kuboki-takeshi/opamp_ishikai_2026-05-06/readme.md

# ISHI会 OPAMP製造記録

## 概要

私、Shuntaro OHNOがISHI会の「[2025年09月イベント：二日でOPAMP回路ハンズオン](https://ishikai.connpass.com/event/363412/)」で作成したオペアンプ（OPAMP）の製造記録です。

設計の目標、設計の流れ・考えていたこと、製造されたOPAMPの計測結果をまとめました。

## 目標

- 初めての半導体製造なので、なんとか動くオペアンプを作りたい
- 指定された面積（600um × 200um）にレイアウトを押し込みたい

## 【2026/05/06】「愛の説教部屋」でご指導いただきたいこと

[2026年5月イベント「ISHI会三周年記念イベント～学生＆新人、半導体初心者に贈る！～」東京会場](https://ishikai.connpass.com/event/381973/)の「愛の説教部屋」にて、広島大学の久保木先生にお伺いしたいことをまとめました。

設計時に私が考えていたことや、製造されたOPAMPの計測記録はこの後にまとめています。
素人が付け焼刃で作った記録をご覧に入れるのは大変心苦しいのですが、どうぞ厳しいコメントをいただけますと幸いです。

- 「設計の流れ・考えていたこと」で、根本的に誤解していることや、もっと時間をかけて検証すべきだったことはありますか？とくに、以下の点が気になっています。
    - バイアス電流・バイアス電位の正しい決め方が知りたいです。設計時はその重要性を軽視していて、適当に決めたり、シミュレーションサンプルのデフォルト値をとりあえず使ったりしてしまいました。また、製造されたOPAMPの計測結果からは、バイアス電流が不足していたのではないかと疑っています。
    - 各MOSのオーバードライブ電圧は、明確に決めておいた方が良いのでしょうか？もしかして、オーバードライブ電圧を全MOSで統一しておいた方が良い、ということもあるのでしょうか？その場合、Vgsは低消費電力を狙ってVth+0.1V=0.9V程度にするのが良いのか、差動増幅段の出力である1.5V程度に余裕を持たせる方が良いのか、知りたいです。

> - 大きな誤解はなさそうですが、個々の要素回路とそれらを組み合わせた際の整合がやや取れていないように見えました。一方、時間をかけて検証するべき点としては、回路の定数決定の際に1回だけではなく何度かループさせて検証することをおすすめしたいと思います。今回と採用した設計手法はすべてのトランジスタが想定した動作店で動作する際にシステマティックに定数が決まるというものですが、実際にはDC, AC, TRANのシミュレーション結果を見て、いったん決めた定数を微調整する必要があります。回路設計の際の仕様（とりあえず動くものとはいえ利得や帯域などの目標値）や設計回路をシミュレーション(または実測も）で評価するテストベンチが定まっていると、電気特性の不審な点に気づくこともあります。
>
>     - 現在の設定ではカレントミラーのMOSは線形領域で動作している可能性があります。重要なのは各段に必要な電流をどのように見積もるのかであり、その電流を分配するのがこのバイアス電流とカレントミラーです。この時に必要な電流は、設計するオペアンプで想定するSRと負荷容量（＋できれば仮置きした位相補償容量）の積で求まる電流が2段目の最低限必要な電流となります。同様に差動増幅段についても、SRと位相補償容量と2段目CSのゲート容量の和との積で1段目差動増幅段の最低限必要な電流になると考えられます。
>
>     - これは悩ましいところです。今回のように"とりあえずなんとか動くもの"であれば、私なら全部同じオーバードライブ電圧、できれば0.2Vに統一して設計すると思います。こうしておくとgmがIDの10倍として近似できるためです。これで一旦設計して飽和領域で動かないときには0.1Vで検討すると思いますが、電源電圧に十分余裕があるためおそらく0.2Vで問題ないかと思います。オーバードライブ電圧を下げるのは低消費電力動作というよりは低電源電圧ですべてのトランジスタを飽和領域で動かすための方策の一つと考えます。
    
- レイアウトをさらに改善する方法が知りたいです。とくに、以下の点が気になっています。
    - とても長い配線ができてしまいましたが、これはやはり問題ですか？このような長い配線を作らないためには、どのような工夫がありますか？
    - ガードリングを付けた方がいいと聞いたので、とりあえずたくさん囲ってみましたが、やりすぎでしょうか？囲うべきところ、囲うべきでないところを知りたいです。
    - 今回は、レイアウトテクニックとして「ガードリング」、「コモンセントロイド」、「ダブルビア（打ち方が正しいか自信がないので、コメントをいただけますと幸いです）」のみ実践しました。他のテクニックも含めて、それぞれの効果から比較した、採用すべき優先順位を知りたいです。

> - 回路図の並びでレイアウトする問題や課題が起こりがちですが、フロアプランを予め検討しておくとよいです。
>     - 良くはないのですが今回はそれほど問題ないと思います。対策としてはフロアプラン（どの場所に何を配置するのか、マッチングや配線長を含めて検討して計画する）の策定が挙げられます。
>     - 状況によりますが、基本的には囲むべきと考えます。基盤/WELLの電位を安定させるためにも基本的には必要と考えた方がよいと思います。
>     - 設計者にとってプロセスに対する信頼度に依存しますが、今回の場合なら私ならGR~DB>CSの順番です。

- 次は、高周波信号に対応したOPAMPを作ってみたいです。Lを小さくする必要があると思いますが、その際の設計で注意すべきことは何ですか？また、1umプロセスだと、どのくらいの周波数にまで対応できるでしょうか？

> - 負荷・構成・消費電力などの条件に依存しますが、同様の条件であれば500kHz～1MHz程度は達成できるのではないでしょうか。

## 設計の流れ・考えていたこと

[ハンズオン資料](https://github.com/ishi-kai/openmpw-transistor-level-examples/blob/main/TR10/docs/OPAMP_TR10.pdf)の流れに沿って、以下のように考えながら設計しました。

### MOSFETの基本設計

#### シミュレーション

- nfet_idvgs.sch
- nfet_idvds.sch
- pfet_idvgs.sch
- pfet_idvds.sch

#### 設計方針

短チャネル長変調効果によって動作が不安定になると困るので、Lは最小の1umではなく3umにしました。

W=30um, L=3umで測定した各MOSFETのパラメータは以下のとおりです。

|W=30um, L=3um|pMOS|nMOS|
|:--:|---:|---:|
|Vth|727mV|794mV|
|Id|3.56uA|6.76uA|
|gm|31.6uS|79.4uS|
|rds = 1/gds|17.9MΩ|38.2MΩ|
|gm × rds (intrinsic gain)|565|3030|
|Gain|55.0dB|69.6dB|

「Wが同じ場合、nMOSにはpMOSの倍のIdが流れるんだな～」程度の解像度で考えていました。

以降はL=3umに固定し、Wは30umの倍数で設定することにしました。

> Lを最小寸法にせず設計したのはGood。λが抑えられます。

> 一方でパラメータを求める際にVds=2.5Vとなっており、実際にこの回路でかかる電圧は3-4V程度（たぶん電源電圧5Vと思われます）ではないかと考えられるため、実際のトランジスタの状態とは異なる場合もあることは留意いただければと思います。プッシュプルなら妥当ですが本構成では動作点がずれる可能性があります。

### OPAMPの全体像

最終的なOPAMPとして、以下の回路を作ります。

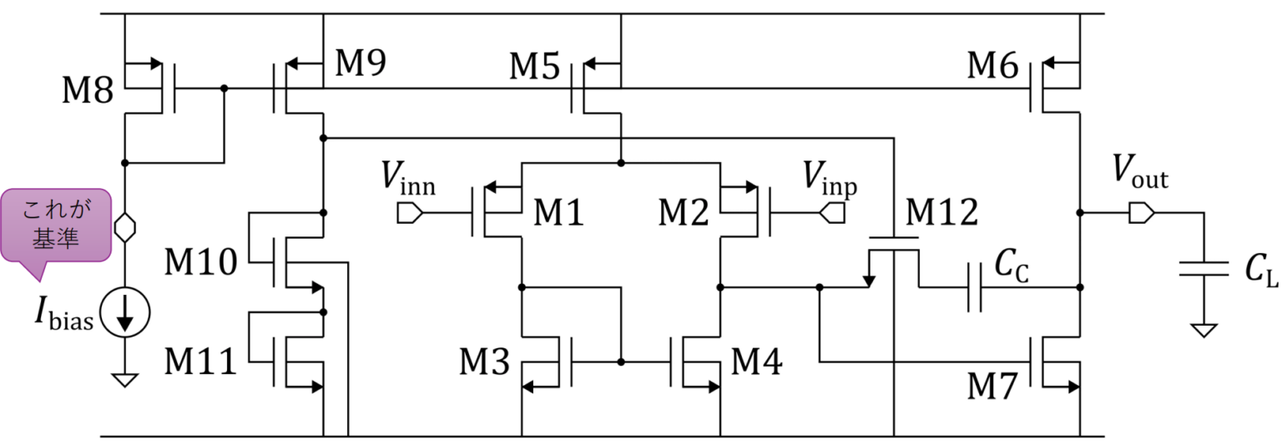
[picture p1: images/circuit.png]
OPAMPの全体像


以降は各MOSのWを設定します。

### カレントミラー（Ibiasの設定）

#### シミュレーション

- ibias_rds.sch

#### 設計方針

M8をとりあえずW=90umとすると、Vgs=0.9V、Vds=2.5Vの条件下で**Id=11.8uA**となりました。
これをバイアス電流（Ibias）として、外部電流源から「引き抜く」ことにします。

> 後にある各段の設計でもありますが、カレントミラーのゲート電位Vg(Ibの端子電位)=3.5V想定では、Vgs=5.0-3.5=1.5V程度、Vds=3.5Vになるような条件で求める必要がありますが、当該の条件とは異なっており、想定した動作状態になっているかをよく確認する必要があります。λも大きそうなのでちょっと心配。

### ソース接地増幅回路

#### シミュレーション

- cs.sch
- cs.sym
- cs_tran.sch

#### 設計方針

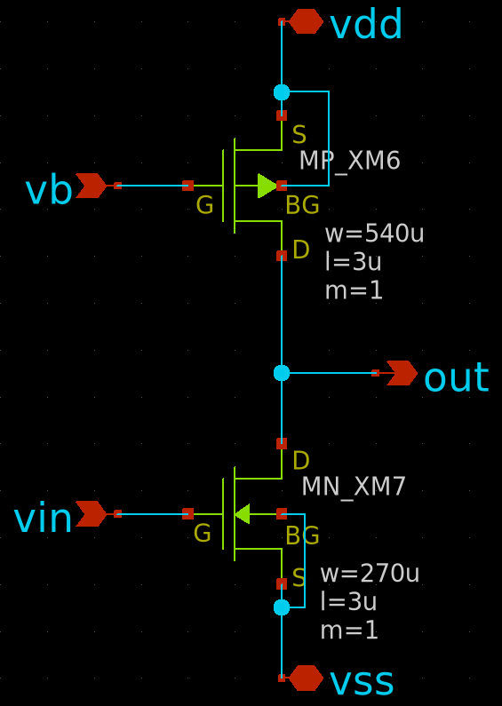
[picture p2: images/cs.png]
ソース接地増幅回路


Vout=Vdd/2となるように、pMOS/nMOSのIdの比に基づいてサイズを調整しました。
「MOSFETの基本設計」で計測した結果、以下のとおり、pMOS/nMOSのIdの比が約1:2だったので、Wの比は2:1になるようにしました。

> 図面にはありませんがテストベンチでは100pFの負荷で求めています。後の比較のため注釈。

|W=30um, L=3um|pMOS|nMOS|
|:--:|---:|---:|
|Vth|727mV|794mV|
|Id|3.56uA|6.76uA|
|gm|31.6uS|79.4uS|

そのうえで、「十分なスルーレートが得られるよう
に大きな電流を流すこと」というハンズオン資料の指示に従い、pMOSはW=540um, nMOSは270umと大きめにしてみました。

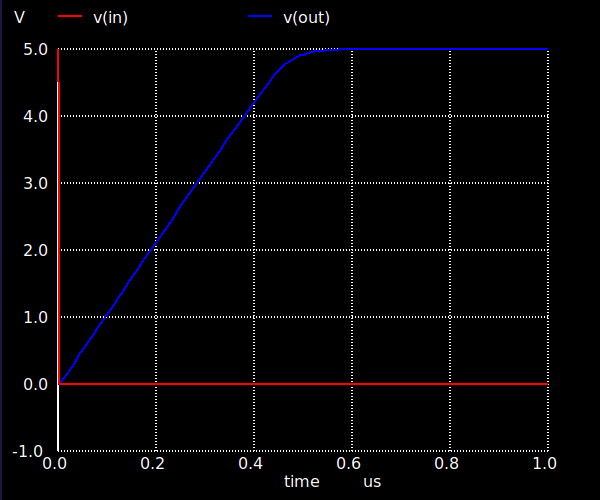
[picture p3: images/sr.png]
ソース接地増幅回路のスルーレート


スルーレートを計測したところ、0V→5Vの立ち上がりにかかる時間が0.5us（2MHz）だったので、十分だと判断しました。

> SR=5V/0.5us=10V/usになります。これはこの回路が許容できる最大の波形の傾きであり、信号の周期ではありません。そのため歪まない最大の正弦波周波数は約1.59MHzになります。（振幅1V=2Vppのとき）

> 正弦波のSRは次の通り
> 信号振幅A（このときVppは2A）、周波数fのとき、時間波形V(t)は下記の通り。SRはその時間微分。SRが最大になるのはt=0のとき。
```math
V(t) = A \sin \omega t = A \sin (2 \pi ft) , 
\frac{dV(t)}{dt} = 2 \pi f A \cos (2\pi ft) , 
SR = 2\pi fA [\rm{V/s}]
```

（ただし、ハンズオン資料では「Vb=5.0-(Vth+Vod) ～ 3.0あたりにすること」と指示されている`cs_tran.sch`のVbの設定はよくわからなかったので、シミュレーションサンプルと同じVb=3.5Vでスルーレートを計測しました。もしかして、バイアス電流を受けるM8のシミュレーションに合わせて、5.0-0.9=4.1Vにするべきだったかも…？以降のシミュレーションもVb=3.5Vで固定していますが、ちゃんと考慮する必要があったのかもしれません）

> その通りですが、この回路ではVbを直接変更できるので、これを電圧制御に変更して3.5Vと設定すると想定通りに動く可能性があります。

### 差動増幅回路

#### シミュレーション

- diff.sch
- diff.sym
- diff_ac.sch
- diff_dc.sch
- 2stage_ac.sch

#### 設計方針

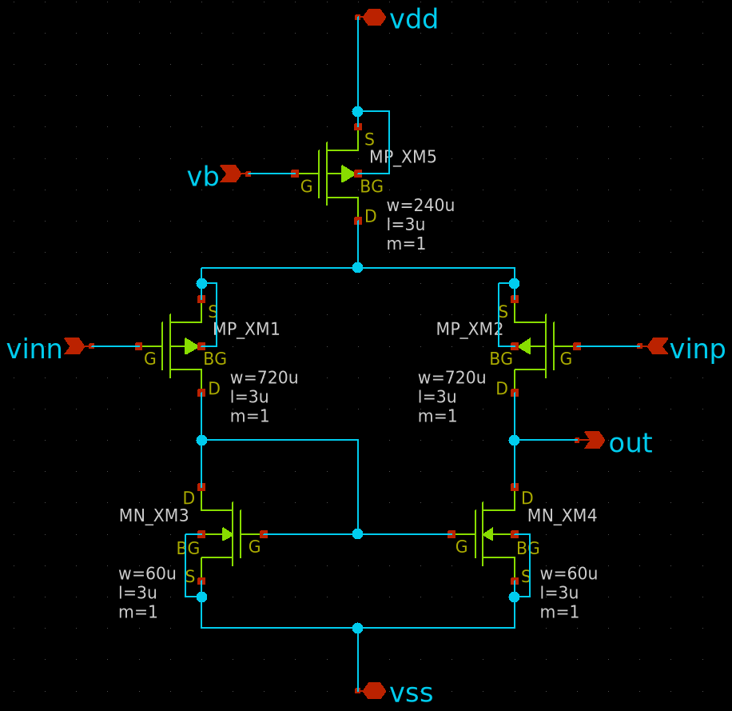
[picture p4: images/diff.png]
差動増幅回路


ハンズオン資料から、各MOSのWの設定について、今回の場合以下の条件があることを把握しました。

- M3, M4は小さくていいが、M3=M4
- M5 : M3+M4 = 2 : 1
- M1, M2は大きくして、M1=M2

レイアウト面積が許す限り大きくした方がいいような気がしたので、以下のように設定しました。

|MOS|MOSのタイプ|Wのサイズ|
|:--:|:--:|---:|
|M1, M2|pMOS|720um|
|M3, M4|nMOS|240um|
|M5|pMOS|60um|

AC解析（`diff_ac.sch`）を実施して、M4のVdsが1.36Vになりました。
ここがハンズオン資料（1.47V）と比較して低いので、2段目（ソース接地増幅回路）との兼ね合いが悪くなっているような気がしています。
実際、差動増幅回路の周波数特性は以下のように良い感じになったのですが、2段目と組み合わせると平坦部がほとんどなくなってしまいました（`2stage_ac.sch`）。

> 1.47Vを見つけることができませんでしたが、Vbが変わってオーバードライブが変わったため、L:1umから3umに変更が要因として考えられます。

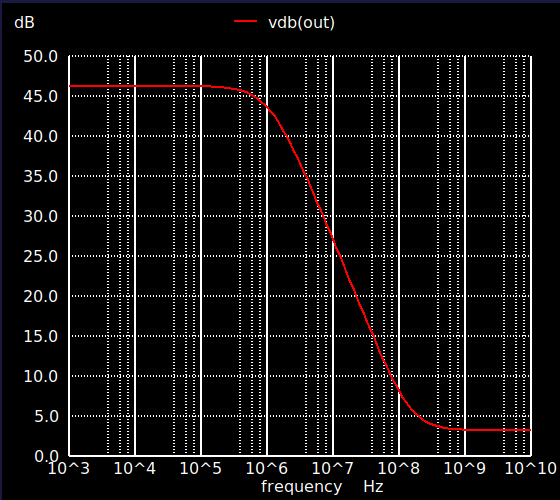
[picture p5: images/diff_ac.png]
差動増幅回路の周波数特性


DC解析（`diff_dc.sch`）を実施すると、出力電圧の上限が3.5Vであることがわかりました。
Rail-to-Railにするためのレイアウト面積はなさそうなので、今回はこれで妥協しました。
（同様に、今回はプッシュプル出力段も省略しました）

### 位相補償とOPAMP

#### シミュレーション

- opamp.sch
- opamp.sym
- opamp_ac.sch

#### 設計方針

「なんとか動くオペアンプを作りたい」が目標なので、位相補償用のコンデンサは最大の容量である8.856pFに設定しました。
> 少し大きいかも。。これは想定する負荷容量に依存しますが、ディスクリートピンで10～数十pF、高速対応だと5pFくらいだったと思うので、この値だと負荷容量と同じ程度で効果が薄くなる可能性があります。逆に想定負荷が100pFだと少ないかもしれません。零点を上げるためにはCcを下げるか、Rcを上げる必要があります。

バイアスレプリカを形成するM9, M10, M11のWの条件について、ハンズオン資料から以下のように読み取りました。

- M6 : M9 = M7 : M11、つまり、M9 = 2 × M11
- M10 = M11

あまり大きさは必要ない気がしたので、M9はW=120um、M10とM11はW=60umにしました。
また、M12はとりあえず最小サイズのW=30umにしました。

AC解析（`opamp_ac.sch`）を実行した結果、周波数特性の平坦部はほとんどなくなってしまいました。

> 要注意点。テストベンチの負荷が1Fになっているように見えます。

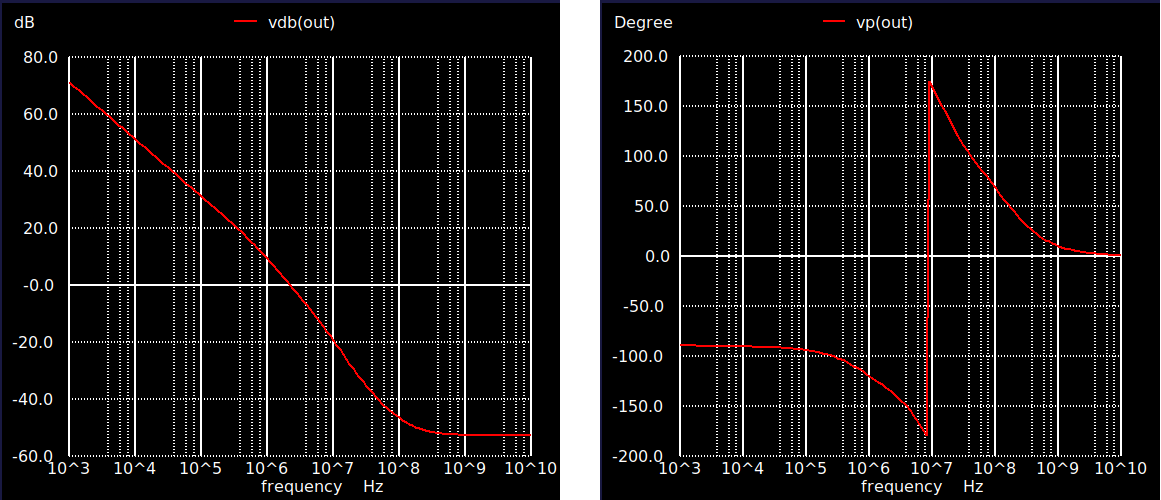
[picture p6: images/opamp_spec.png]
OPAMPの周波数特性


設計時は位相補償の影響かな…と考えていましたが、後から考えると2段目との兼ね合いの影響も？という気がしています。
平坦部はないものの、100kHzでも一応ゲインがあるのでOKということにしました。
また、シミュレーションの結果的には、M12が飽和領域で動いていないような気もするけど…、とりあえず動いてそうなのでヨシ！

### レイアウト

#### GDS

- opamp.gds

#### 設計方針

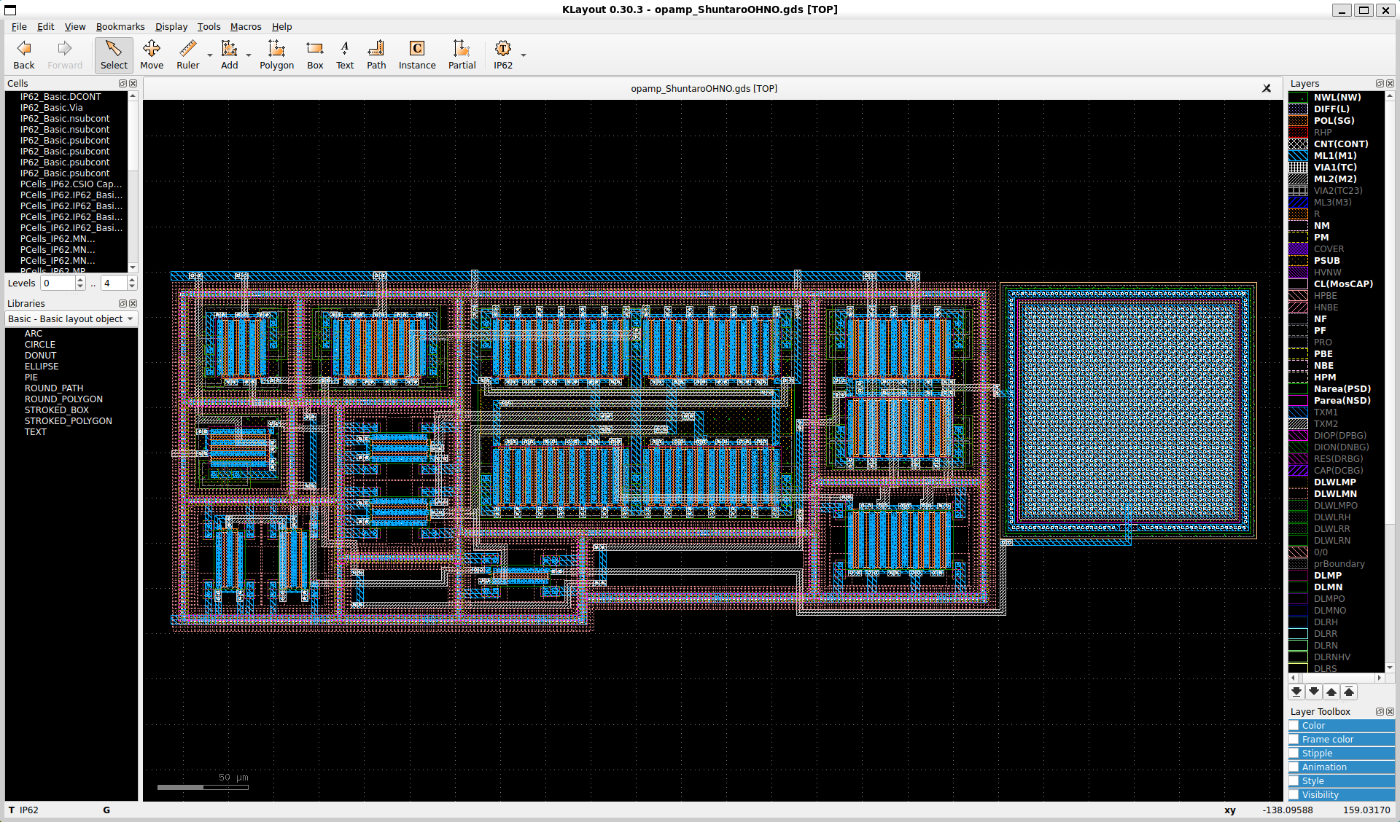
[picture p7: images/layout.png]
完成したレイアウト


わりと好き勝手に設計をしたあと、600um × 200umのレイアウト面積はかなりギリギリということに気付いたので、とにかく領域内に押し込むことに専念しました。

> MOSが90度回転しているところがありますが、ばらつき抑制のためにはMOSのゲートは単一方向にそろえた方がよいです。

その際、囲えそうなところはガードリングで囲ってみましたが、囲うべきところとそうでないところの区別は曖昧です。
> 状況次第ですが、タップも併せて確保できるので、基本的には囲むべきと思います。

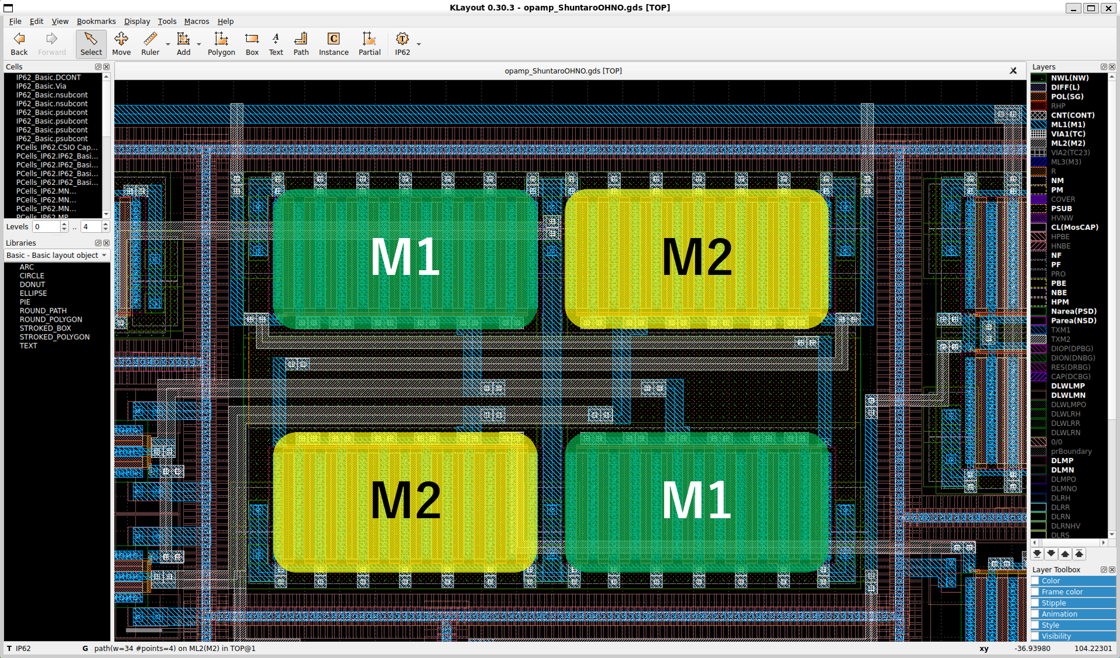
[picture p8: images/common.png]
コモンセントロイド


さらに、M1とM2にコモンセントロイドを適用しました。
ビアはとりあえずダブルにした方がいいと聞いたので2つ並べてみましたが、効果的な打ち方になっているかは自信がないです。

> ダブルビアはOK。プロセスに対する信頼によりますが、できるならやった方がいいです。また大電流が想定されるときにはダブルと言わずたくさん打つ方がよいです。
> おおまかに～10Ω/個

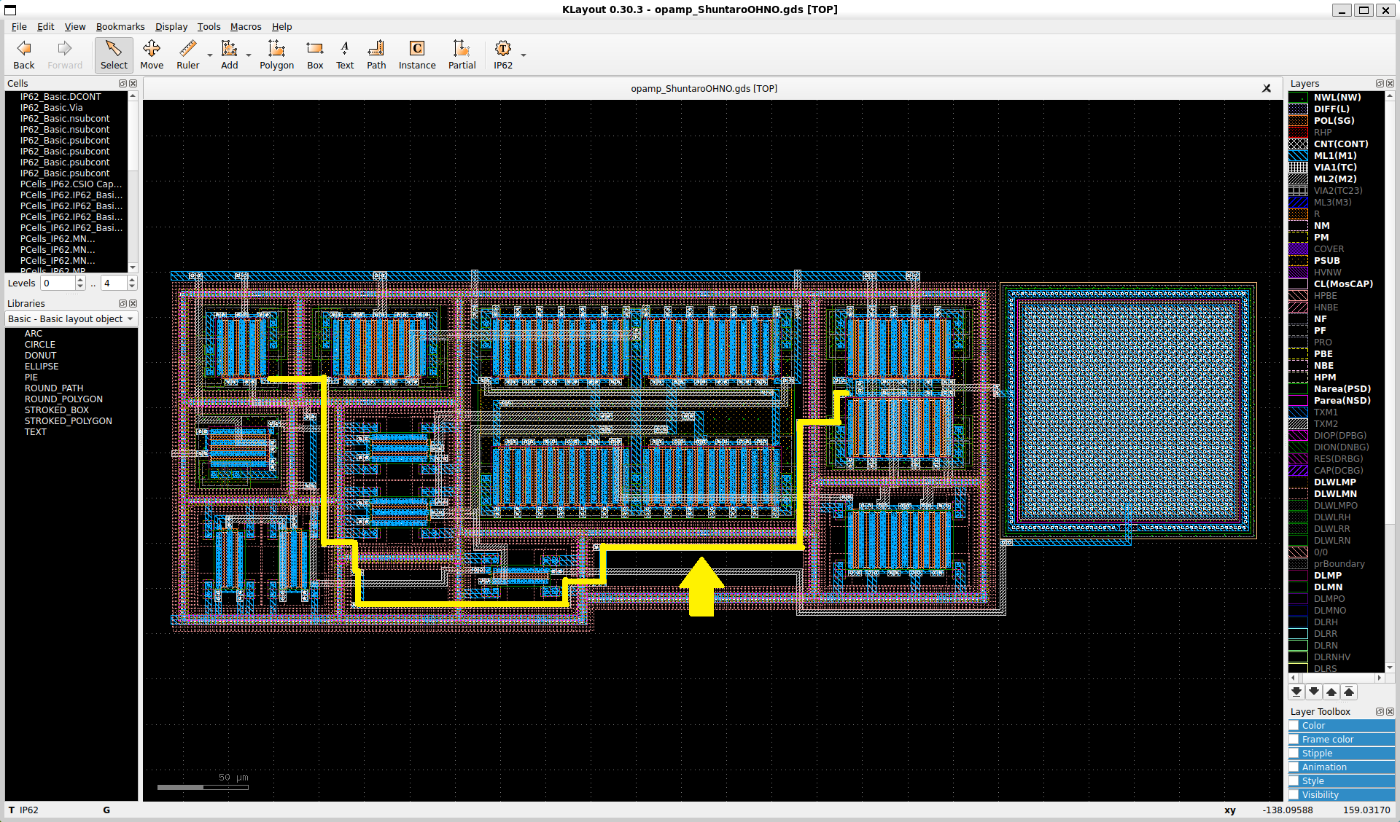
[picture p9: images/route.png]
最長の配線


レイアウトを領域内に押し込むことには成功しましたが、その結果、非常に長い配線ができてしまいました（黄色）。
なんとなく、あまり良くないような気がします。

> M6のゲートバイアス廃線と思われます。良くはないですが今回は許容できると思います。電流制御だとまずいですが、MOSのカレントミラーは電圧制御なので、このノードの電位が動かないようにすることが重要です。したがって長い配線は許容可能と考えました。ただし、信号配線と交差する箇所には配線間容量が生じ、特に高速に電位が変化するときに容量を通してこのノードの電位が変動する可能性があります。

## 製造されたOPAMPの測定

製造されたOPAMPを計測しました。
その際、設定したバイアス電流の11.8uAを引き抜く電流源を使用しました。

### 電圧フォロワ

#### 出力電圧

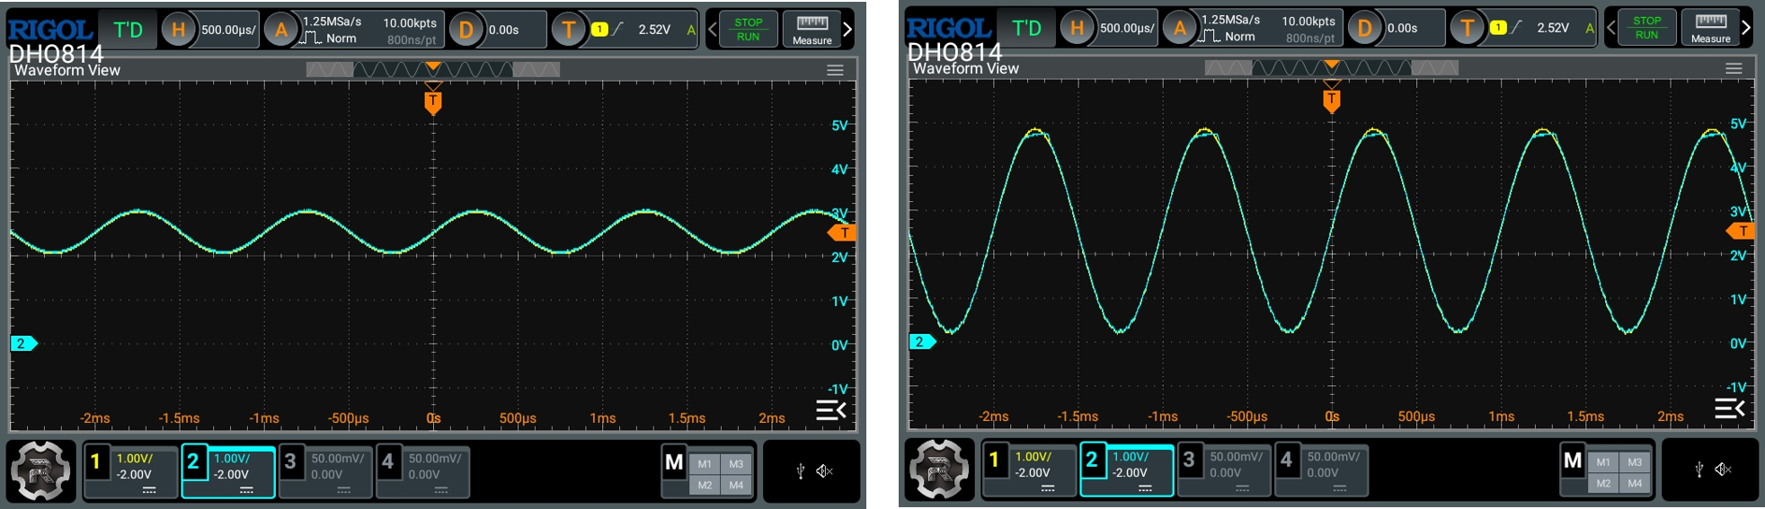
[picture p10: images/amp.png]
電圧フォロワ


製造したOPAMPで電圧フォロワを組み、1kHzの正弦波を入力しました。
正弦波の振幅を上げていくと、上の電圧が4.6V程度に達したところで歪みました。
下側はまだ余裕がありそうです。

> この結果からは2段目のドレインは約4.6Vと想定され、設計時想定の条件と異なっている可能性があります。

#### 周波数応答

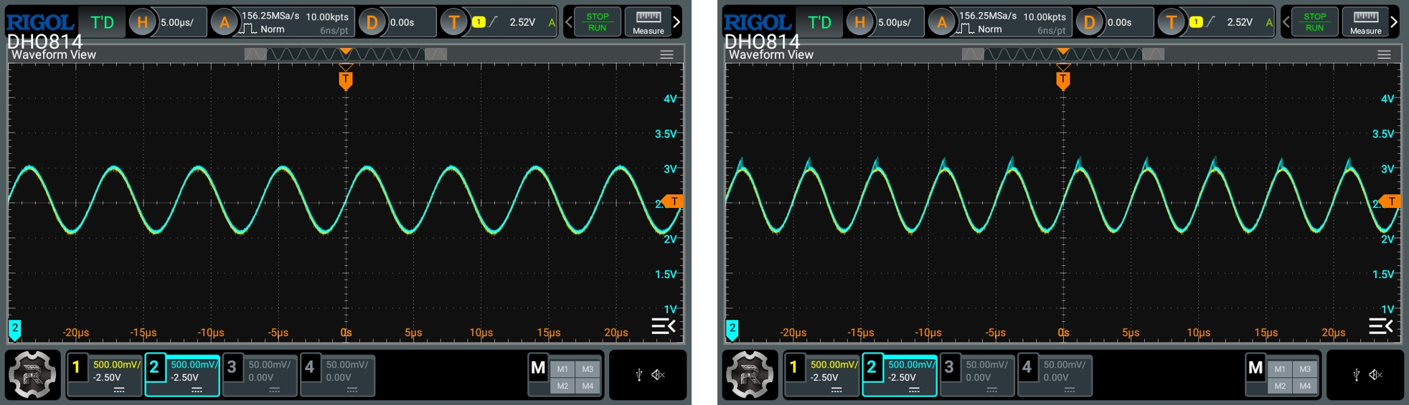
[picture p11: images/freq_1vpp.png]
1Vp-p周波数応答


振幅を1Vp-pに固定し、正弦波の周波数を上げていきました。
160kHz程度までは大丈夫そうでしたが、200kHzでは波形が崩れました。

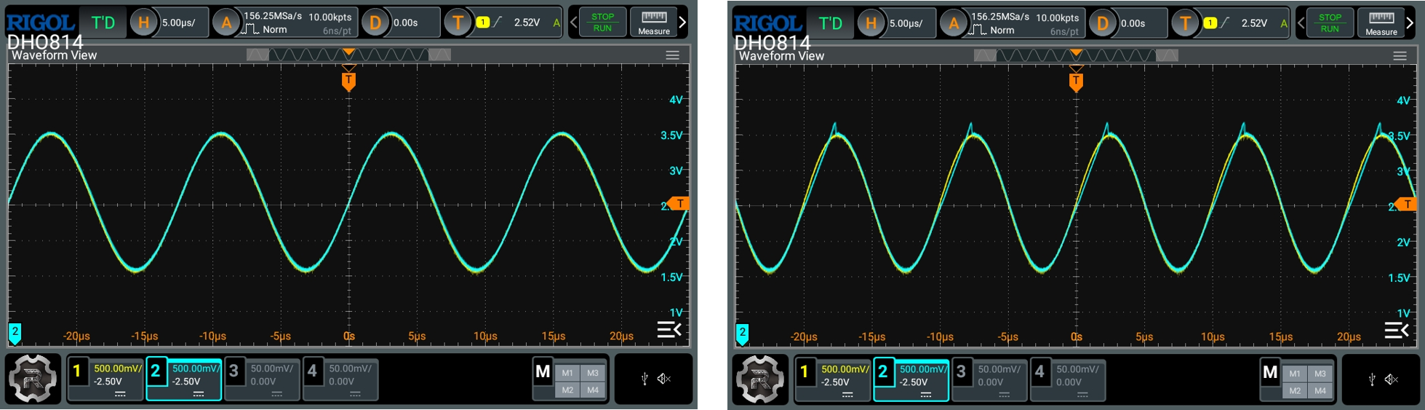
[picture p12: images/freq_2vpp.png]
2Vp-p周波数応答


振幅を2Vp-pに固定した場合は、100kHzで波形が崩れました。
80kHz程度までが適正範囲のようです。

> SRは0.628V/us程度と考えられます。

### 反転増幅回路

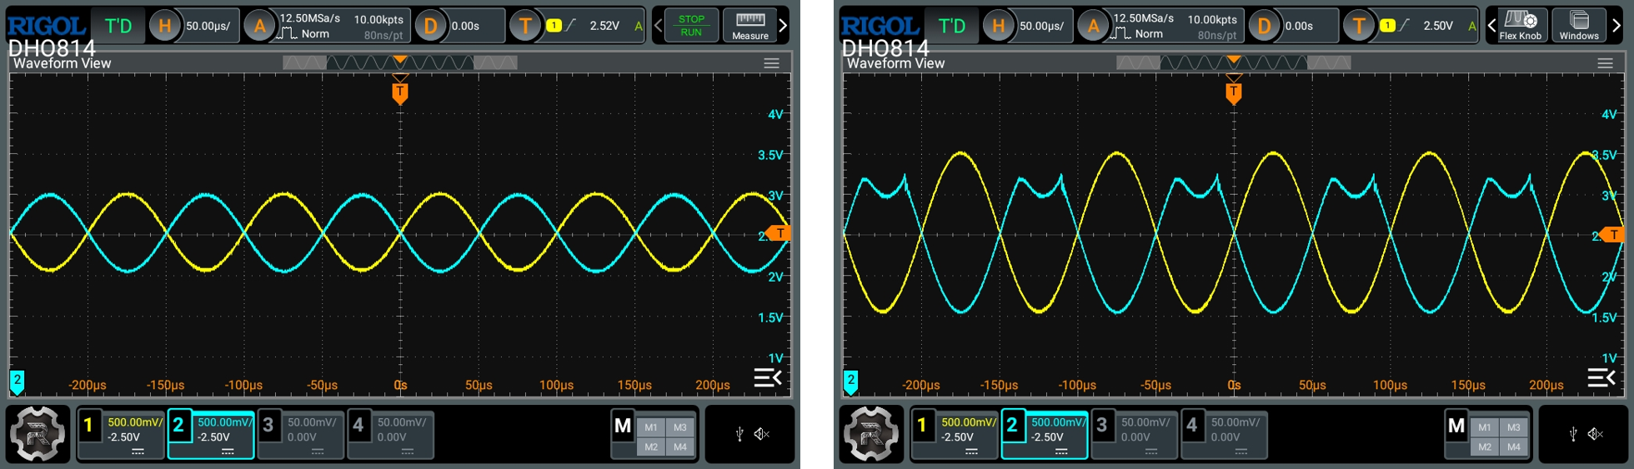
[picture p13: images/inv1.png]
反転増幅回路（Ib=11.8uA）


次に、OPAMPで1倍の反転増幅回路を組みました。
10kHzの正弦波を1Vp-pで入力した場合は正常に動作しましたが、振幅を2Vp-pにすると、出力波形（水色）の上端で「鏡像」のような反転が見られました。

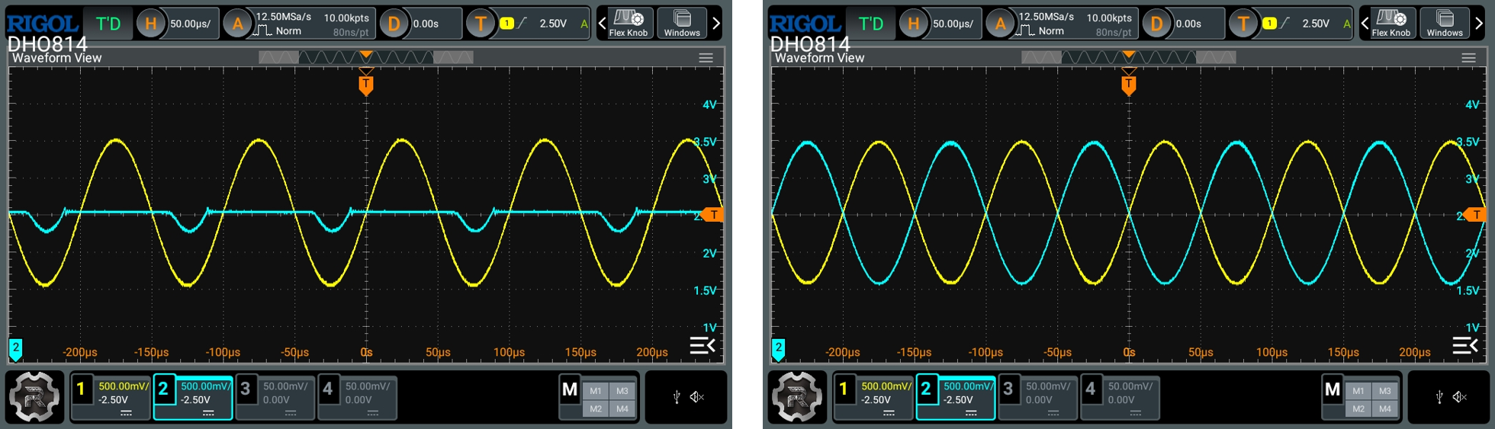
[picture p14: images/inv2.png]
反転増幅回路（Ibを増やした）


原因を探るため、OPAMPの反転入力端子の電位を計測した結果が上図の左です。
（基準電位2.5Vを受ける非反転入力端子とイマジナリーショートを形成するため、）反転入力端子の電位は一定に保たれるはずですが、入力信号（黄色）に対し、「鏡像反転」が生じたタイミングで電位が落ち込んでいます。

> 鏡像のようになっている点からはバイアス電流が想定と異なりカレントミラーや負荷が想定と違った、テストベンチの設定（具体的に抵抗の値）がよくなかった点も考えられます。1つ目はibの端子を電圧制御に変更することで特性改善するかを確認できます。2つ目については帰還抵抗があまりに小さいとオペアンプから駆動できる電流の上限に達してしまい正常に動作しないのが原因のため、抵抗値を数kΩとすると動作する可能性があります。

動作電流（バイアス電流Ib）の不足が原因かもしれないと思ってIbを増やしてみたところ、2Vp-pでも正常に動作しました。
バイアス電流は1回のシミュレーションで適当に決めたので、もっと時間をかけて考えるべきだったと反省しています。
