kuboki-takeshi/opamp_ishikai_2026-05-06/ISHI-KAI_OPAMP_MASAHIRO_20260506_kuboki.pptx

## ISHI会オペアンプ設計

Masahiro

## コンセプト

- RF（数MHz）でも使えるオペアンプ

## 設計の基本方針

- 初段の差動増幅にnMOSFETを使用
  - みんなpMOSFETだからnMOSFETにしてみたかった
- ２段目はカスコードにする
  - ミラー効果減らして高域まで使えるようにできそう

## 全体回路

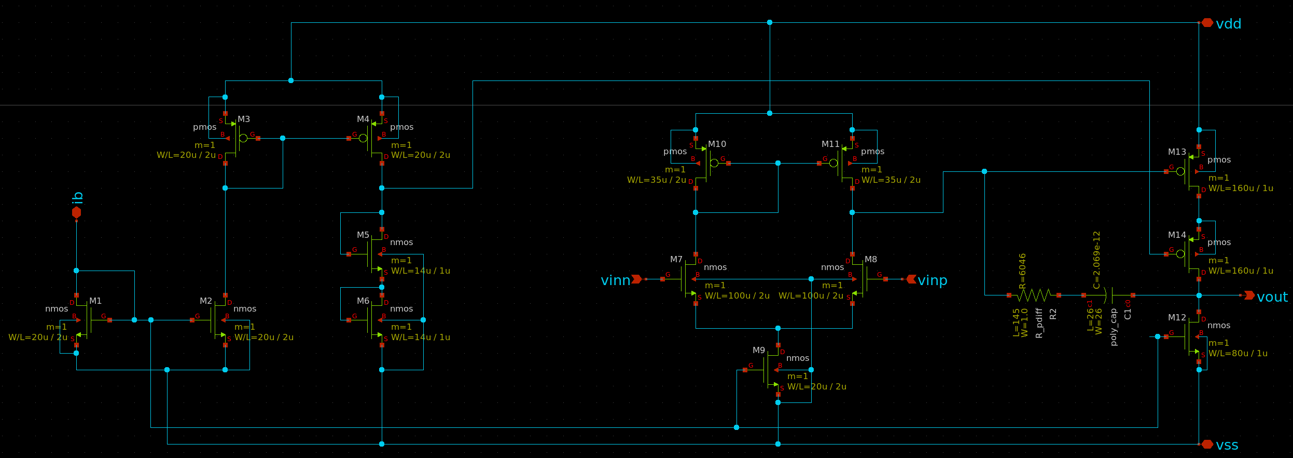
[picture p15: figure]

バイアス生成部

差動増幅回路

２段目

位相補償

## レイアウトの方針

- とりあえず動くレイアウトにする
  - LVSは絶対にパスするようにする
- 回路図となるべく同じ配置にする
  - あとで訳わからなくなるの怖かった

## レイアウト

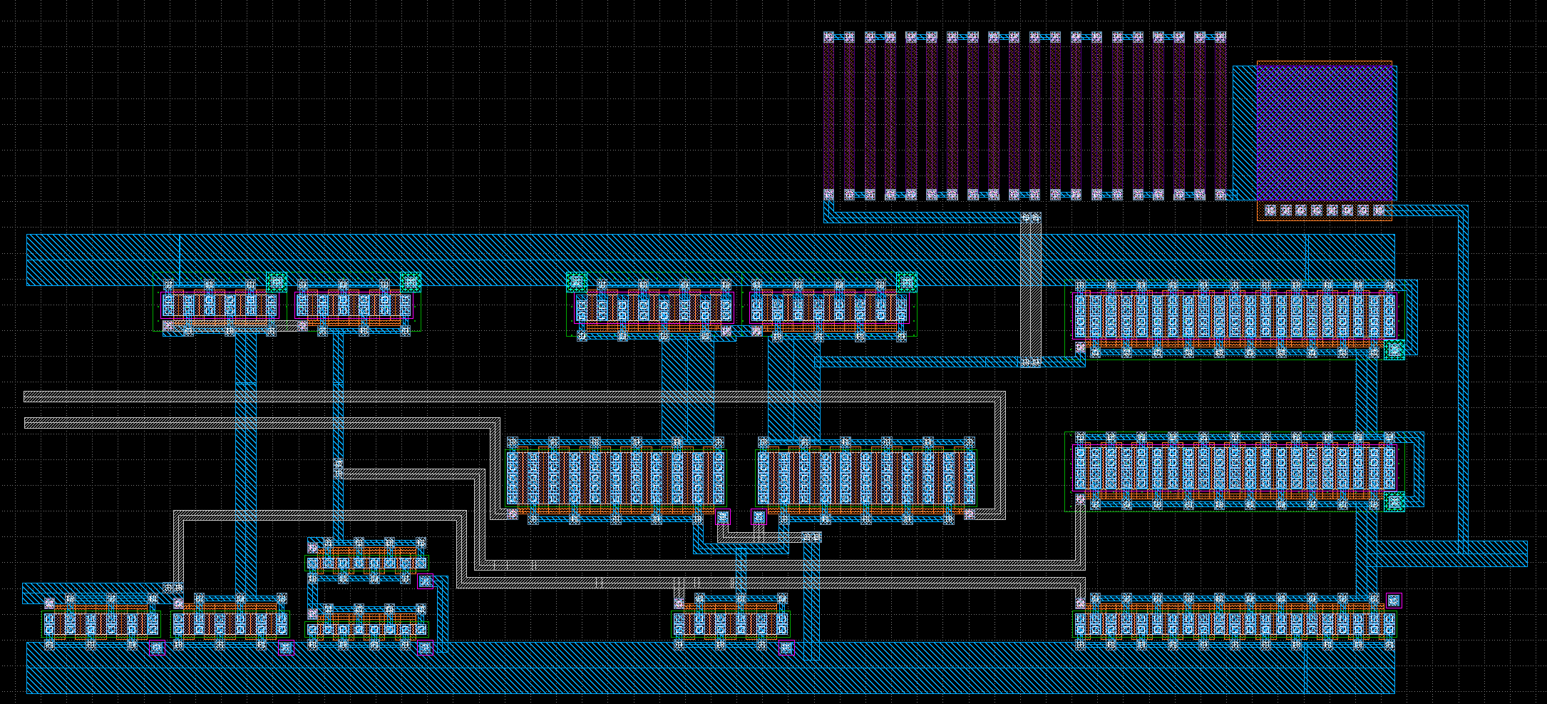
[picture p16: figure]

vss

vinp

vinn

ib

vout

vdd

## 反省

- 回路図通りに並べて配線しただけで工夫が無い
  - ガードくらいは入れれば良かったと思う
- 配線が細い
  - もっと太く短く配線できたはず
- フィンガーの端から配線を取り出しているので、 両端で電位の違いがありそう
